hpvdt/weather-station/README.md

# weather-station
Weather station project
