hpvdt/weather-station/hardware/motherboard/motherboard.kicad_pcb

## KiCad design hardware/motherboard/motherboard.kicad_pcb (2024-01-23)

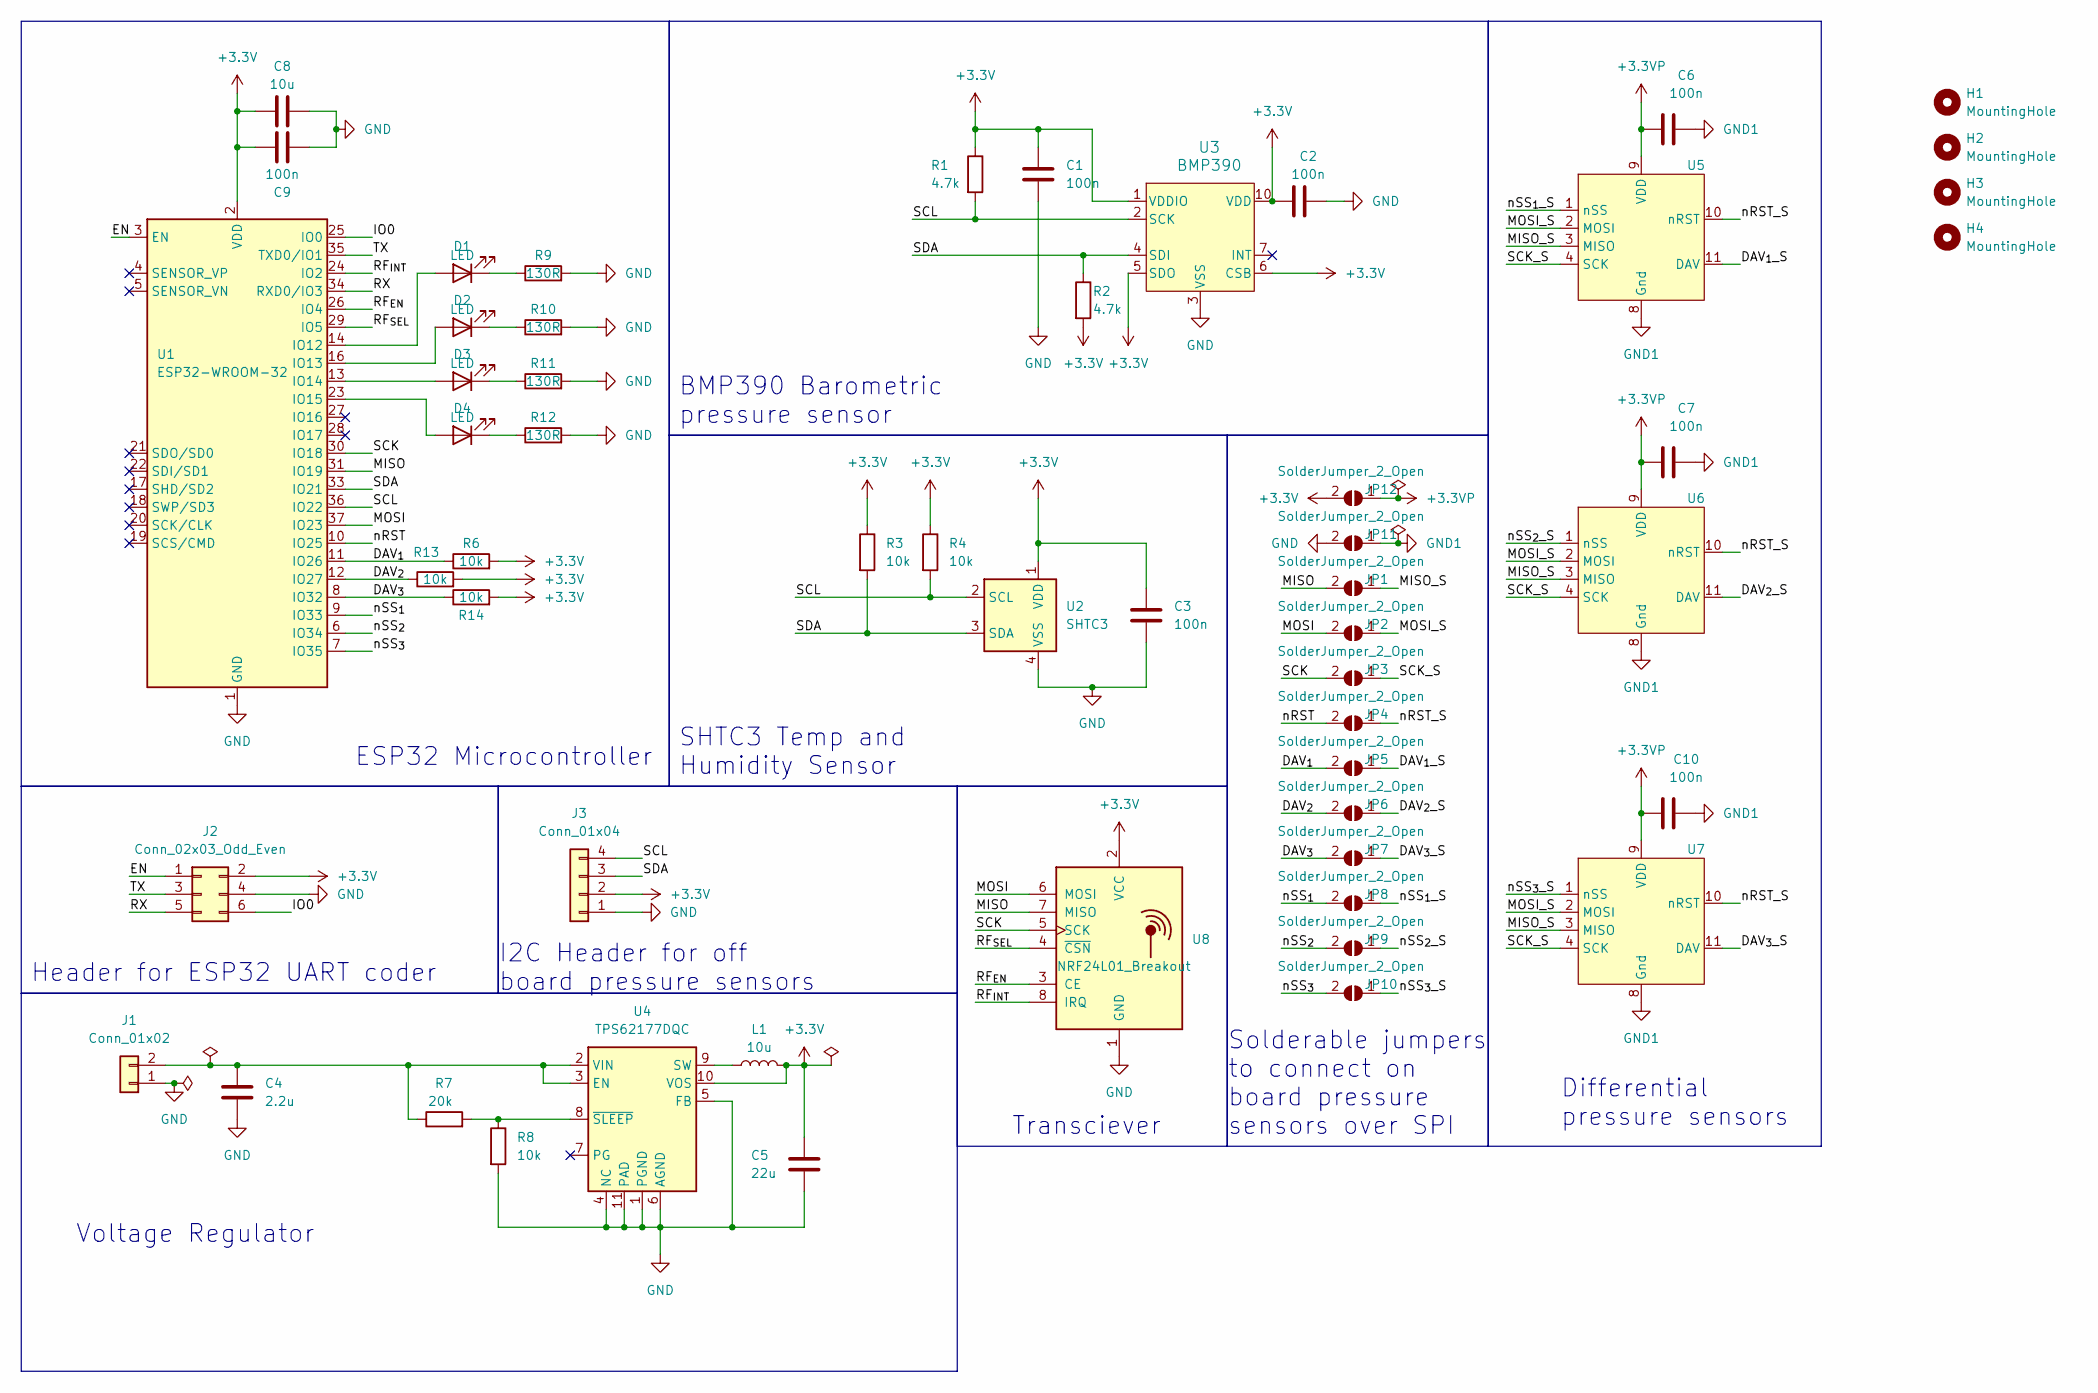
[picture p1: schematic motherboard.kicad_sch, Weather Station Main Board]

Parts:
C1, C2, C3, C6, C7, C9, C10: 100n; C_0603_1608Metric
C4: 2.2u; C_0603_1608Metric
C5: 22u; C_0805_2012Metric
C8: 10u; C_0805_2012Metric
D1, D2, D3, D4: LED; LED_0805_2012Metric
H1, H2, H3, H4: MountingHole; MountingHole_3mm
J1: Conn_01x02; AMASS_XT60-F_1x02_P7.20mm_Vertical
J2: Conn_02x03_Odd_Even; IDC-Header_2x03_P2.54mm_Vertical
J3: Conn_01x04; PinSocket_1x04_P2.54mm_Vertical
JP1, JP2, JP3, JP4, JP5, JP6, JP7, JP8, JP9, JP10, JP11, JP12: SolderJumper_2_Open; SolderJumper-2_P1.3mm_Open_RoundedPad1.0x1.5mm
L1: 10u; L_Taiyo-Yuden_MD-4040
R1, R2: 4.7k; R_0603_1608Metric
R3, R4, R6, R8, R13, R14: 10k; R_0603_1608Metric
R7: 20k; R_0603_1608Metric
R9, R10, R11, R12: 130R; R_0603_1608Metric
U1: ESP32-WROOM-32; ESP32-WROOM-32D
U2: SHTC3; Sensirion_DFN-4-1EP_2x2mm_P1mm_EP0.7x1.6mm
U3: BMP390; LGA10_BMP390_BOS
U4: TPS62177DQC; WSON-10-1EP_2x3mm_P0.5mm_EP0.84x2.4mm_ThermalVias
U5, U6, U7: HV120SM02C
U8: NRF24L01_Breakout; nRF24L01_Breakout

Connections:
+3.3V: C1.1, C2.1, C3.1, C5.1, C8.2, C9.2, J2.2, J3.2, JP12.2 (B), L1.2, R1.1, R2.2, R3.1, R4.1, R6.2, R13.2, R14.2, U1.2 (VDD), U2.1 (VDD), U3.1 (VDDIO), U3.5 (SDO), U3.6 (CSB), U3.10 (VDD), U4.10 (VOS), U8.2 (VCC)
+3.3VP: C6.1, C7.1, C10.1, JP12.1 (A), U5.9 (VDD), U6.9 (VDD), U7.9 (VDD)
/DAV_{1}: JP5.2 (B), R6.1, U1.11 (IO26)
/DAV_{1}_S: JP5.1 (A), U5.11 (DAV)
/DAV_{2}: JP6.2 (B), R13.1, U1.12 (IO27)
/DAV_{2}_S: JP6.1 (A), U6.11 (DAV)
/DAV_{3}: JP7.2 (B), R14.1, U1.8 (IO32)
/DAV_{3}_S: JP7.1 (A), U7.11 (DAV)
/EN: J2.1, U1.3 (EN)
/IO0: J2.6, U1.25 (IO0)
/MISO: JP1.2 (B), U1.31 (IO19), U8.7 (MISO)
/MISO_S: JP1.1 (A), U5.3 (MISO), U6.3 (MISO), U7.3 (MISO)
/MOSI: JP2.2 (B), U1.37 (IO23), U8.6 (MOSI)
/MOSI_S: JP2.1 (A), U5.2 (MOSI), U6.2 (MOSI), U7.2 (MOSI)
/RF_{EN}: U1.26 (IO4), U8.3 (CE)
/RF_{INT}: U1.24 (IO2), U8.8 (IRQ)
/RF_{SEL}: U1.29 (IO5), U8.4 (~CSN)
/RX: J2.5, U1.34 (RXD0/IO3)
/SCK: JP3.2 (B), U1.30 (IO18), U8.5 (SCK)
/SCK_S: JP3.1 (A), U5.4 (SCK), U6.4 (SCK), U7.4 (SCK)
/SCL: J3.4, R1.2, R4.2, U1.36 (IO22), U2.2 (SCL), U3.2 (SCK)
/SDA: J3.3, R2.1, R3.2, U1.33 (IO21), U2.3 (SDA), U3.4 (SDI)
/TX: J2.3, U1.35 (TXD0/IO1)
/nRST: JP4.2 (B), U1.10 (IO25)
/nRST_S: JP4.1 (A), U5.10 (nRST), U6.10 (nRST), U7.10 (nRST)
/nSS_{1}: JP8.2 (B), U1.9 (IO33)
/nSS_{1}_S: JP8.1 (A), U5.1 (nSS)
/nSS_{2}: JP9.2 (B), U1.6 (IO34)
/nSS_{2}_S: JP9.1 (A), U6.1 (nSS)
/nSS_{3}: JP10.2 (B), U1.7 (IO35)
/nSS_{3}_S: JP10.1 (A), U7.1 (nSS)
GND: C1.2, C2.2, C3.2, C4.2, C5.2, C8.1, C9.1, J1.1, J2.4, J3.1, JP11.2 (B), R8.2, R9.2, R10.2, R11.2, R12.2, U1.1 (GND), U1.15 (GND), U1.38 (GND), U1.39 (GND), U2.4 (VSS), U3.3 (VSS), U3.8 (VSS), U3.9 (VSS), U4.1 (PGND), U4.4 (NC), U4.5 (FB), U4.6 (AGND), U4.11 (PAD), U8.1 (GND)
GND1: C6.2, C7.2, C10.2, JP11.1 (A), U5.8 (Gnd), U6.8 (Gnd), U7.8 (Gnd)
unnamed: D1.2 (A), U1.14 (IO12)
unnamed: D1.1 (K), R9.1
unnamed: D2.2 (A), U1.16 (IO13)
unnamed: D2.1 (K), R10.1
unnamed: D3.2 (A), U1.13 (IO14)
unnamed: D3.1 (K), R11.1
unnamed: D4.2 (A), U1.23 (IO15)
unnamed: D4.1 (K), R12.1
unnamed: C4.1, J1.2, R7.1, U4.2 (VIN), U4.3 (EN)
unnamed: L1.1, U4.9 (SW)
unnamed: R7.2, R8.1, U4.8 (~SLEEP)

Notes on the sheet:
Header for ESP32 UART coder
I2C Header for off board pressure sensors
Transciever
ESP32 Microcontroller
Solderable jumpers to connect on board pressure sensors over SPI
Voltage Regulator
Differential pressure sensors
BMP390 Barometric pressure sensor
SHTC3 Temp and Humidity Sensor

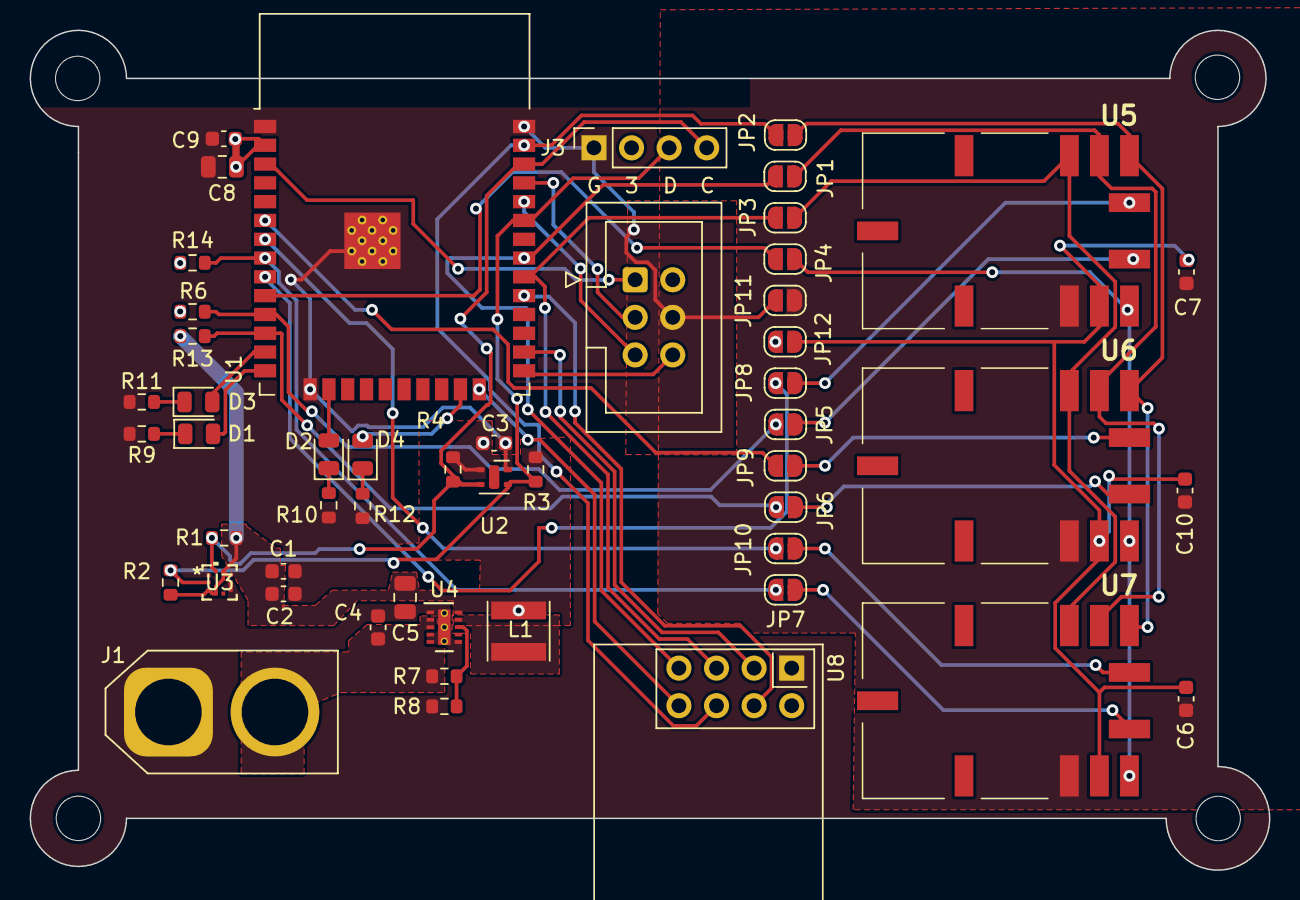
[picture p2: board motherboard.kicad_pcb from above]

Board: 2 copper layers, 83.7 x 56.7 mm, 55 parts (0 on the bottom side), 44 nets.
