hpvdt/weather-station/(commit log)

2023-12-06 Initial Commit
    Uploading first schematic
    [Weather Station Motherboard V1.kicad_pcb, Weather Station Motherboard V1.kicad_sch]
2023-12-06 Added jumpers
    Added jumper connections to seperate pressure sensors unless soldered together
    [Weather Station Motherboard V1.kicad_sch]
2023-12-06 Test commit to pull
    [Weather Station Motherboard V1.kicad_sch]
2023-12-06 On Board Pressure Sensors
    Rerouted on board pressure sensors for SPI with solderable breaks in connections. Added telemetry unit.
    [Weather Station Motherboard V1.kicad_sch]
2023-12-06 Moved hardware files
    Moved hadware files to new "motherboard" project and added footprint for the ND005D complete with model.
    [motherboard.kicad_pcb, motherboard.kicad_sch]
2023-12-06 Schematic with pressure sensors and transciever
    Set up schematic for I2C communication with off board pressure sensors or SPI communication with on board pressure sensors. Added transceiver. Formatted schematic. Added footprints for barometric pressure sensor.
    [motherboard.kicad_sch]
2023-12-07 Power solder connections
    Added solder connections for power and ground because I forgot them last time and updated footprint assignments
    [motherboard.kicad_pcb, motherboard.kicad_sch]
2023-12-08 Completed schematic
    Completed schematic with all footprints assigned
    [motherboard.kicad_pcb, motherboard.kicad_sch]
2023-12-09 Initial PCB design
    Initial PCB design complete
    [motherboard.kicad_pcb, motherboard.kicad_sch]
2023-12-09 Finalized PCB design revision 1
    [motherboard.kicad_pcb]
2023-12-09 Hole change
    [motherboard.kicad_pcb, motherboard.kicad_sch]
2023-12-09 Removed Via bridge
    rerouted one trace to remove via bridge and keep it neatly on one layer
    [motherboard.kicad_pcb]
2023-12-10 Simpler power routing
    Added vias to connect power to flood on back layer rather than running traces on top layer
    [motherboard.kicad_pcb]
2023-12-10 Fixed Decoupling Capaciors for ESP32
    [motherboard.kicad_pcb]
2023-12-10 Fixed Clearance Issues
    [motherboard.kicad_pcb]
2023-12-12 Widened drill holes to 0.3mm
    Edited footprints for the ESP32 and the pressure sensor to increase the via widths to 0.3mm from 0.2mm to make them cheaper to produce
    [motherboard.kicad_pcb]
2023-12-19 BOM changes
    [motherboard.kicad_pcb]
2024-01-18 Baseline blink
    Baseline system to blink one of the status LEDs on the weather station board.
    There is an issue with including the `BMP3XX` library at the present. Will need to investigate further or replace.
    [main.cpp]
2024-01-18 ALL THE LEDs!!
2024-01-23 Bluetooth Sensor Test
    [motherboard.kicad_pcb]
